macmv/robotic-gripper/gripper-adapters/UR3/UR3_adapter.step

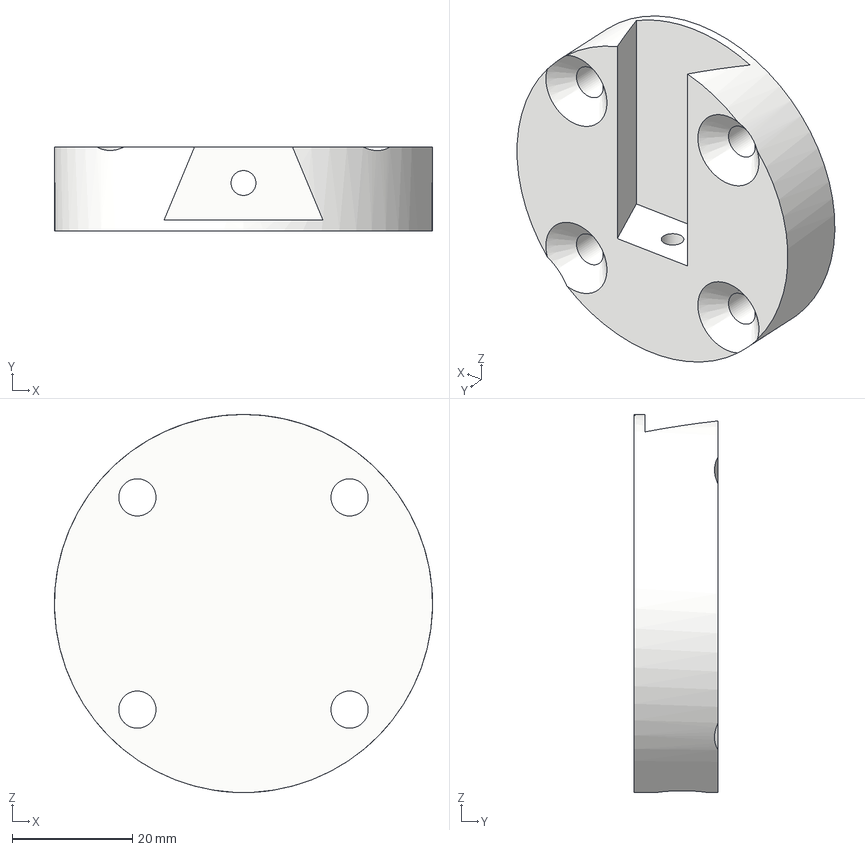
[picture p1: CAD file, 2026-02-05]
gripper-adapters/UR3/UR3_adapter.step
63.0 x 14.0 x 63.0 mm
