macmv/robotic-gripper/(list of files, cad)

Other CAD files:
pcb/STLs/PCB_spacer.stl
gripper-adapters/UR3/UR3_adapter.stl
