macmv/robotic-gripper/pcb/KiCAD files/GripperBoard.kicad_sch

## KiCad design pcb/KiCAD files/GripperBoard.kicad_sch (2026-02-05)

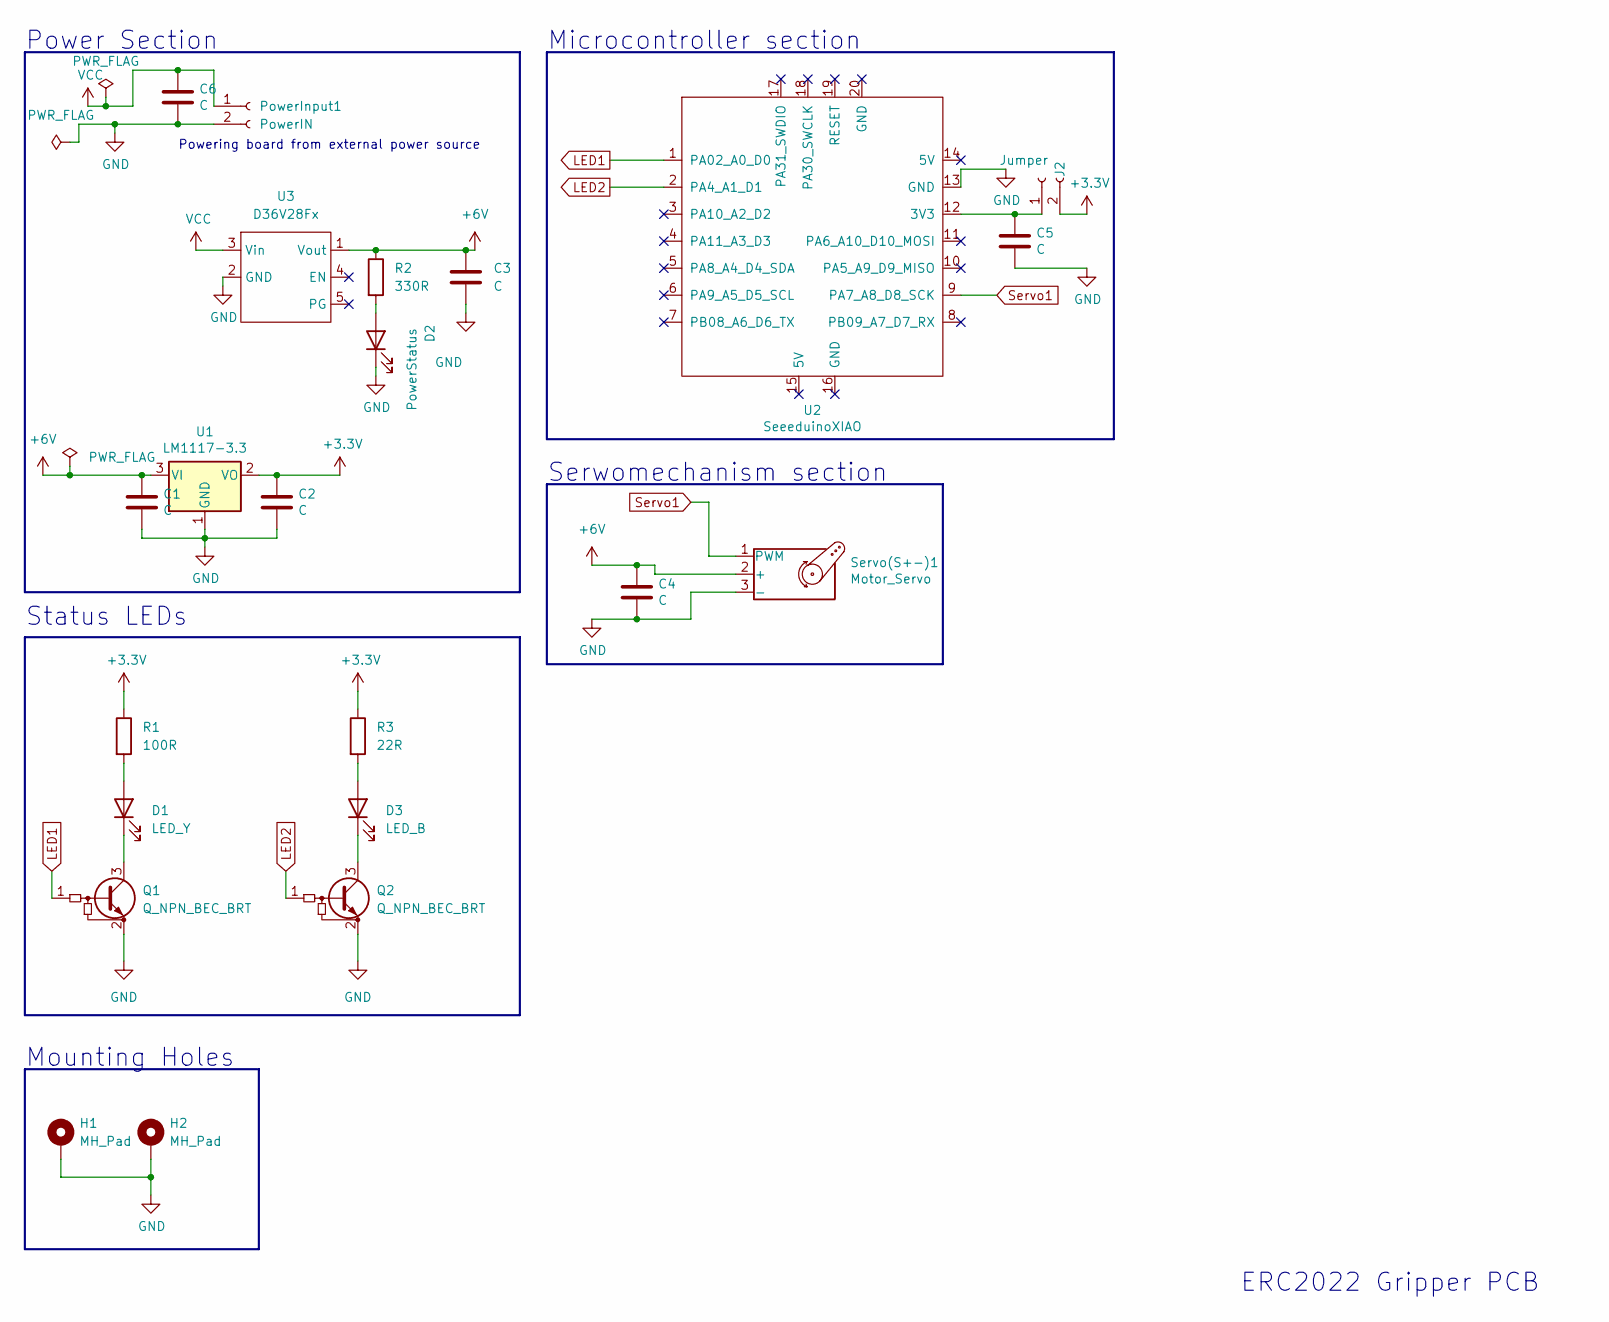
[picture p2: schematic GripperBoard.kicad_sch]

Parts:
C1, C3, C5: C; CP_EIA-3216-18_Kemet-A
C2: C; CP_EIA-6032-28_Kemet-C
C4, C6: C; CP_Elec_6.3x5.8
D1: LED_Y; LED_1206_3216Metric
D2: PowerStatus; LED_1206_3216Metric
D3: LED_B; LED_1206_3216Metric
H1, H2: MH_Pad; MountingHole_3.2mm_M3_DIN965_Pad
J2: Jumper; PinHeader_1x02_P2.54mm_Vertical
PowerInput1: PowerIN; Molex_SL_x02
Q1, Q2: Q_NPN_BEC_BRT; SOT-23
R1: 100R; R_0805_2012Metric
R2: 330R; R_0805_2012Metric
R3: 22R; R_0805_2012Metric
Servo(S+-)1: Motor_Servo; Molex_SL_x03
U1: LM1117-3.3; SOT-223
U2: SeeeduinoXIAO; Seeeduino XIAO-MOUDLE14P-2.54-21X17.8MM
U3: D36V28Fx; D36V28Fx StepDown Voltage Regulator

Connections:
+3.3V: C2.1, J2.2, R1.1, R3.1, U1.2 (VO)
+6V: C1.1, C3.1, C4.1, R2.1, Servo(S+-)1.2 (+), U1.3 (VI), U3.1 (Vout)
GND: C1.2, C2.2, C3.2, C4.2, C5.2, C6.2, D2.1 (K), H1.1, H2.1, PowerInput1.2, Q1.2 (E), Q2.2 (E), Servo(S+-)1.3 (-), U1.1 (GND), U2.13 (GND), U3.2 (GND)
LED1: Q1.1 (B), U2.1 (PA02_A0_D0)
LED2: Q2.1 (B), U2.2 (PA4_A1_D1)
unnamed: C5.1, J2.1, U2.12 (3V3)
unnamed: D1.1 (K), Q1.3 (C)
unnamed: D1.2 (A), R1.2
unnamed: D2.2 (A), R2.2
unnamed: D3.1 (K), Q2.3 (C)
unnamed: D3.2 (A), R3.2
Servo1: Servo(S+-)1.1 (PWM), U2.9 (PA7_A8_D8_SCK)
VCC: C6.1, PowerInput1.1, U3.3 (Vin)

Notes on the sheet:
Microcontroller section
Power Section
Status LEDs
Serwomechanism section
Powering board from external power source
Mounting Holes
ERC2022 Gripper PCB
