macmv/robotic-gripper/(commit log)

2026-02-05 Import upstream repo
    [GripperBOM.xlsx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]
2026-02-05 Rename root directories
    [GripperBOM.xlsx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]
2026-02-05 Toggle the LED from serial commands
2026-02-05 Add an empty rlcpp node that listens to messages to open/close the gripper
2026-02-05 Publish the position as reported by the arduino
